Ninjago77/keyscar/CH552G Developent Board/2024-10-13T19_37_25.713Z-AR4349-Cocket-Nova-Ch552-15-1536x1519.jpg

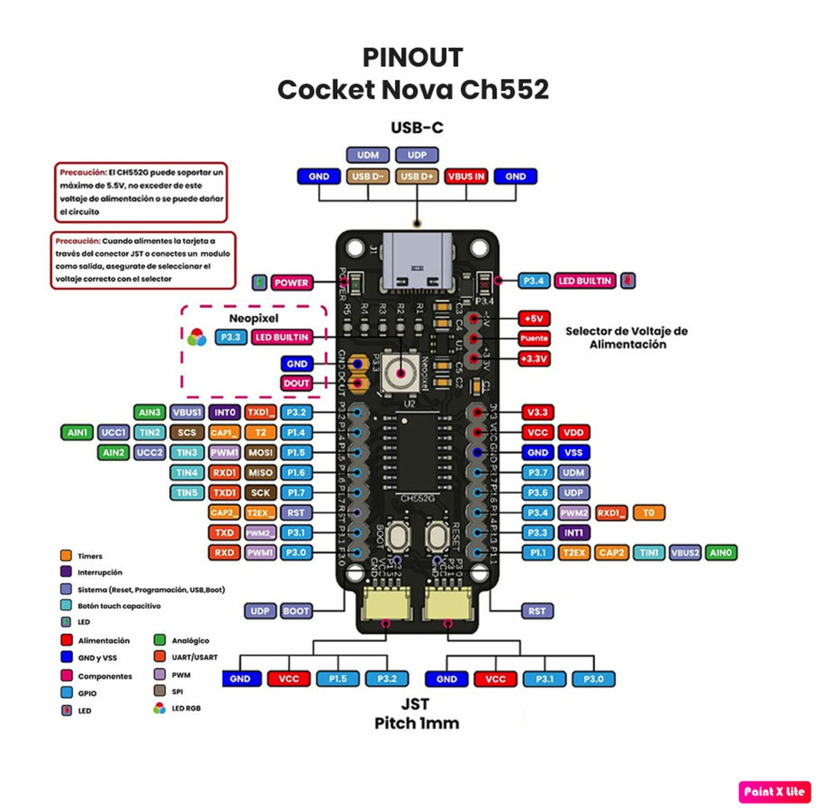
CH552G Developent Board/2024-10-13T19_37_25.713Z-AR4349-Cocket-Nova-Ch552-15-1536x1519.jpg
