Ninjago77/keyscar/images/CHIP_PLAN.png

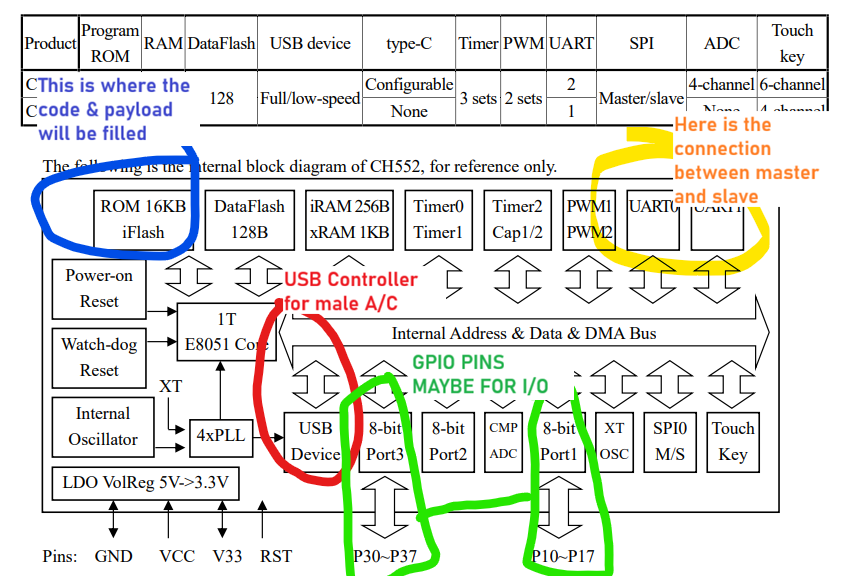
images/CHIP_PLAN.png
