Ninjago77/keyscar/images/flag-standalone-wtransparent.png

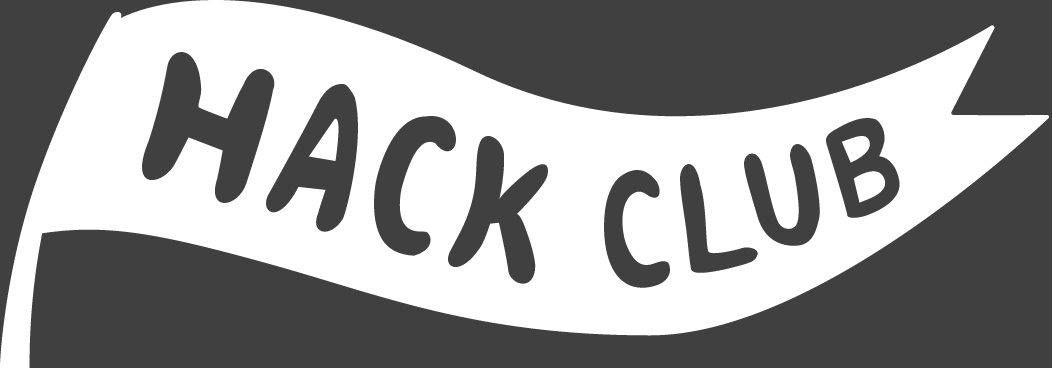
images/flag-standalone-wtransparent.png
