Ninjago77/keyscar/images/hack_monochrome.png

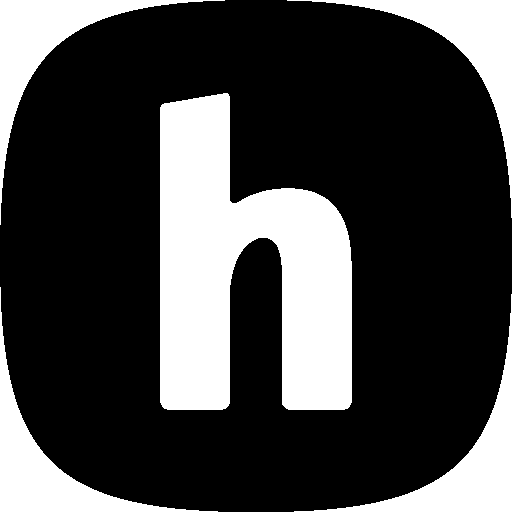
images/hack_monochrome.png
