Ninjago77/keyscar/images/imageedit_2_4769429485.png

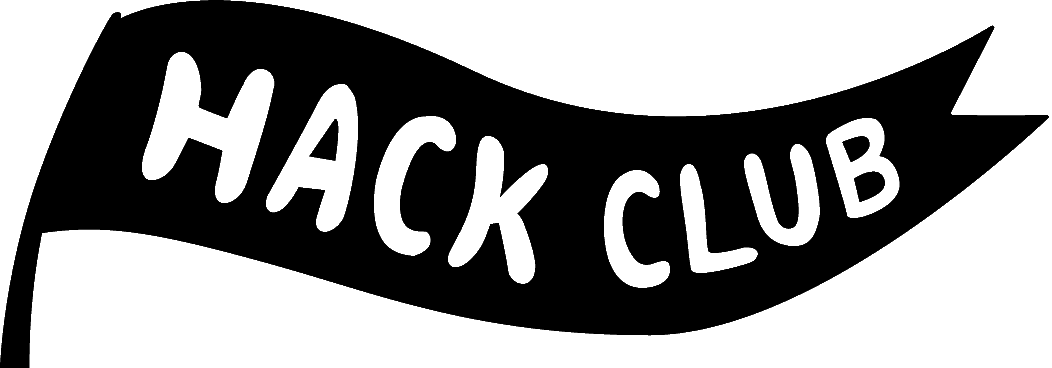
images/imageedit_2_4769429485.png
