Ninjago77/keyscar/images/imageedit_8_5918140750.png

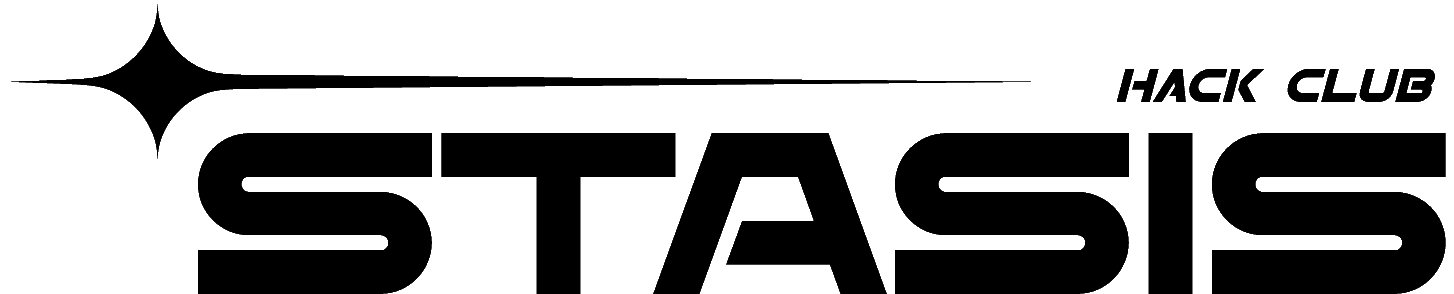
images/imageedit_8_5918140750.png
