Ninjago77/keyscar/images/PLAN.png

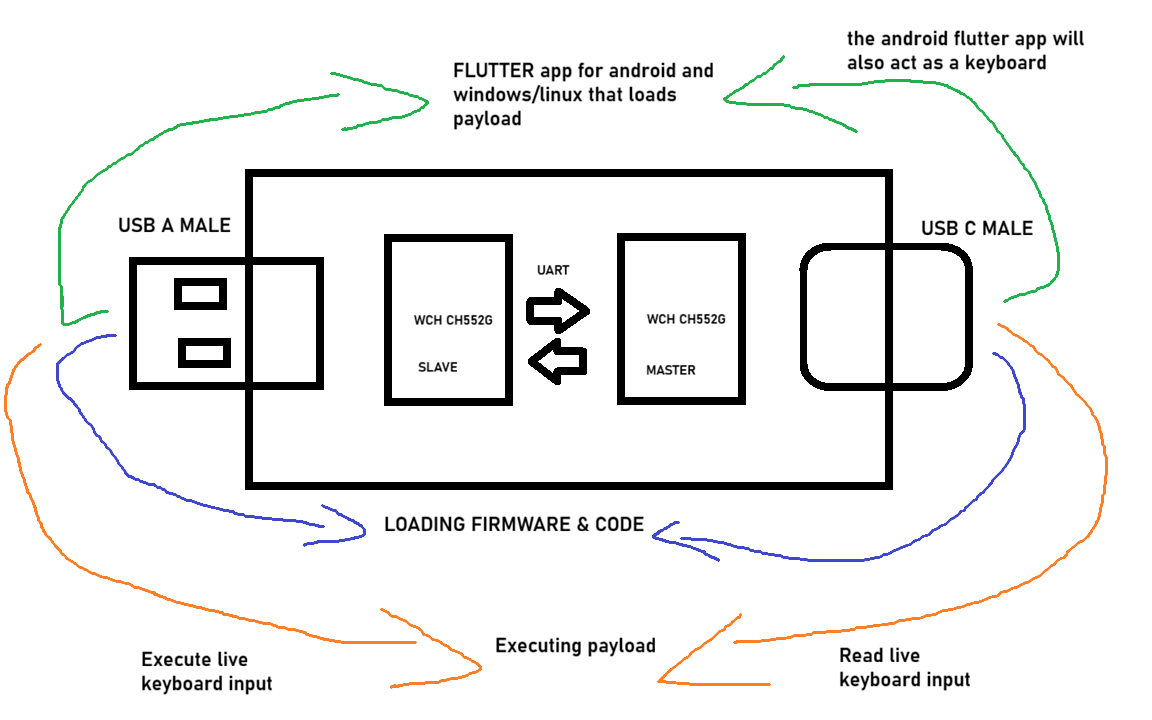
images/PLAN.png
