Ninjago77/keyscar/journal/JOURNAL_9.txt

I think, for now, I will submit the project as a tier 4 with the double-sided smd assembly.

So here are the front and back images from JCLPCB:-
 - 
 - 

And if this, along with my firmware based application, doesnt qualify for tier 4, then I'll redo the entire pcb as one
sided even though it defeats the purpose of it.

Here are the order screenshots:-
 - 
 - 

Here is the BOM CSV:-
 - 

hopefully this goes through!
