Ninjago77/keyscar/journal/JOURNAL_7.txt

So, rn, I need to fix the edge cuts for the pcb due to the drc errors I keep getting.

After some warnings about overlaps, I had to remove the ege cuts on both usb modules,
so they would stop screaming at me.

I think, I have to now go through every single footprint and remove the silkscreen
this is going to be pain.

So, I've completed that, done more touchups:-



Now its time to add the silkscreen, so I got these logos:-
 - hack_monochrome

 - imageedit_2_4769429485

 - imageedit_8_5918140750

It is done!!!:-
 - 

So now, to export and see how much it costs!

Welp, those rst & boot buttons are actually not in stock at JCLPCB,
infact, not a single one with the same footprint is in stock:-
 - 

I think I've found a way, I swapped it from 4.7mmx3.5mm to 3.5mmx4.7mm:-
 - C528967 | EVQP2202M for the rst & boot buttons

I'm going to pray that JCLPCB notices and just rotates to the correct ish footprint.

Okay, the USB C Male also had the same problem, so I found a new one:-
 - C2763098 | 918-118A2021Y40005 for the usb c male

So I think, I will have to modify the schematic and the pcb again for both of these.

The Price also looks insane, what is going on? 
The parts on their own are pretty cheap, but Setup is 50 $$???

I have to swap components and work out the price issue next journal entry.
