Ninjago77/keyscar/journal/JOURNAL_4.txt

Now to move on to actually arranging and wiring the pcb along with fetching footprints.

So before that, I ran the ERC (Electrical Rules Checker),
& I have a lot of pins unassigned, so I'm just tagging them with a passive label.

Turns out I also need to add a 5.1k resistor to GND in the usb c CC pin,
so that it can recieve power at all.
I also need to connect the shield pins on both usb a and c to GND,

so that's what i did:-
 - 
 - 

So... I think all component annotations in kicad need to end with a number,
so I think I'll have to be renaming stuff for a while.
I also had to add a bunch of PWR FLAGS everywhere to tell that it is a power source.

Now I don't have any major errors, so time to move on!

The following are the footprints I'm using:
 - Capacitor SMD:C 0402 1005 Metric
 - SS12's SMA (I had to swap it out from a tht one, so this is actually smt)
 - Neopixel SMD:LED WS2812B PLCC4 5.0x5.Omm P3.2mm
 - USB A Plug: USB_A_Molex_48037-2200_Horizontal
 - resistors: R_0402_1005Metric

I seem to have run into a problem regarding the buttons,
I want the bootsel and reset buttons to be incredibly small,
and the exec buttons to be medium, but finding the footprints for these 
small buttons (3mmx3mm) is pretty hard. Most always give me 6mm footprints.

So, I think, I have to base my footprints off of the actual parts in stock
with JCLPCB. So, here are the 2 buttons that I've picked:-
 - EVQP2D02Q for the bootsel and reset buttons
 - K2-6639SP-C4SC-04 for the EXEC buttons
 - K3-1292S-P2 for the spdt switches
 - GT36549 for the photoresistor

I think at this point, it might be better to add all the components from JCLPCB'S footprint and schematics.
So, rn this is what It looks like before I redo almost all the symbols:-
 - 

Infact, I might just redo all the footprints with the correct ones from JCLPCB,
so... I have to get the models for footprints that I mentioned above,
which means, I'll not be using a single kicad alone footprint.

So, onto more part hunting, based on availability & price (JCLPCB Part number):-
 - C112454 for USB A MALE
 - C2988371 | GT-USB-8016A for USB C MALE // not using this check down.
 - C79160 | EVQP2D02Q for the bootsel and reset buttons
 - C83206 | K2-6639SP-C4SC-04 for the EXEC buttons
 - C145853 | K3-1292S-P2 for the spdt switches
 - C2904883 | GT36549 for the photoresistor
 - C1525 | CL05B104KO5NNNC for the .1uf/ 100nf capacitors
 - C2479 | SS12 for the schottky diodes
 - C2843785 | XL-5050RGBC-2812B for the neopixels
 - C111292 | CH552G for WCH CH552G chip
 - C25531 | 0402WGJ0103TCE for the 10k ohm resistors
 - C25905 | 0402WGF5101TCE for the 5.1k ohm resistors
 - C208984 | RMS04JT330 for the 330 ohm resistors

Now onto the downloading and conversion from easyeda to kicad
for everysingle one of those footprints.

Maybe... I don't have too....
I found this plugin https://github.com/CDFER/JLCPCB-Kicad-Library
 - 

I also think I might have to install this one: https://github.com/Bouni/kicad-jlcpcb-tools

Those get me all the footprints, but I think I also need the symbols, so I must use this:-
https://pypi.org/project/JLC2KiCadLib/
and it works beautifully!

While converting my old symbols into the new ones,
I seem to have into a problem, GT-USB-8016A is a usb c female part
& I can't seem to find a usb C male part anywhere.
So as of right now, I'm going to stick with the current symbol as it is pretty descriptive.

FINALLY, it is done:-
 - 

Now to move onto the actual pcb design, as I say that, I realize that I need to,
first upload all the footprints and link them to their 3d models that I got from the pypi script
then I need to link all the footprints with their symbols.

Which I now have done!, so here is what the pcb looks like rn:
 - 

Hope I'll be able to wire it all up next journal entry and figure out the weird usb c male issue.
