Ninjago77/keyscar/keyscar_kicad/keyscar_kicad.kicad_pcb

## KiCad design keyscar_kicad/keyscar_kicad.kicad_pcb (2026-03-21)

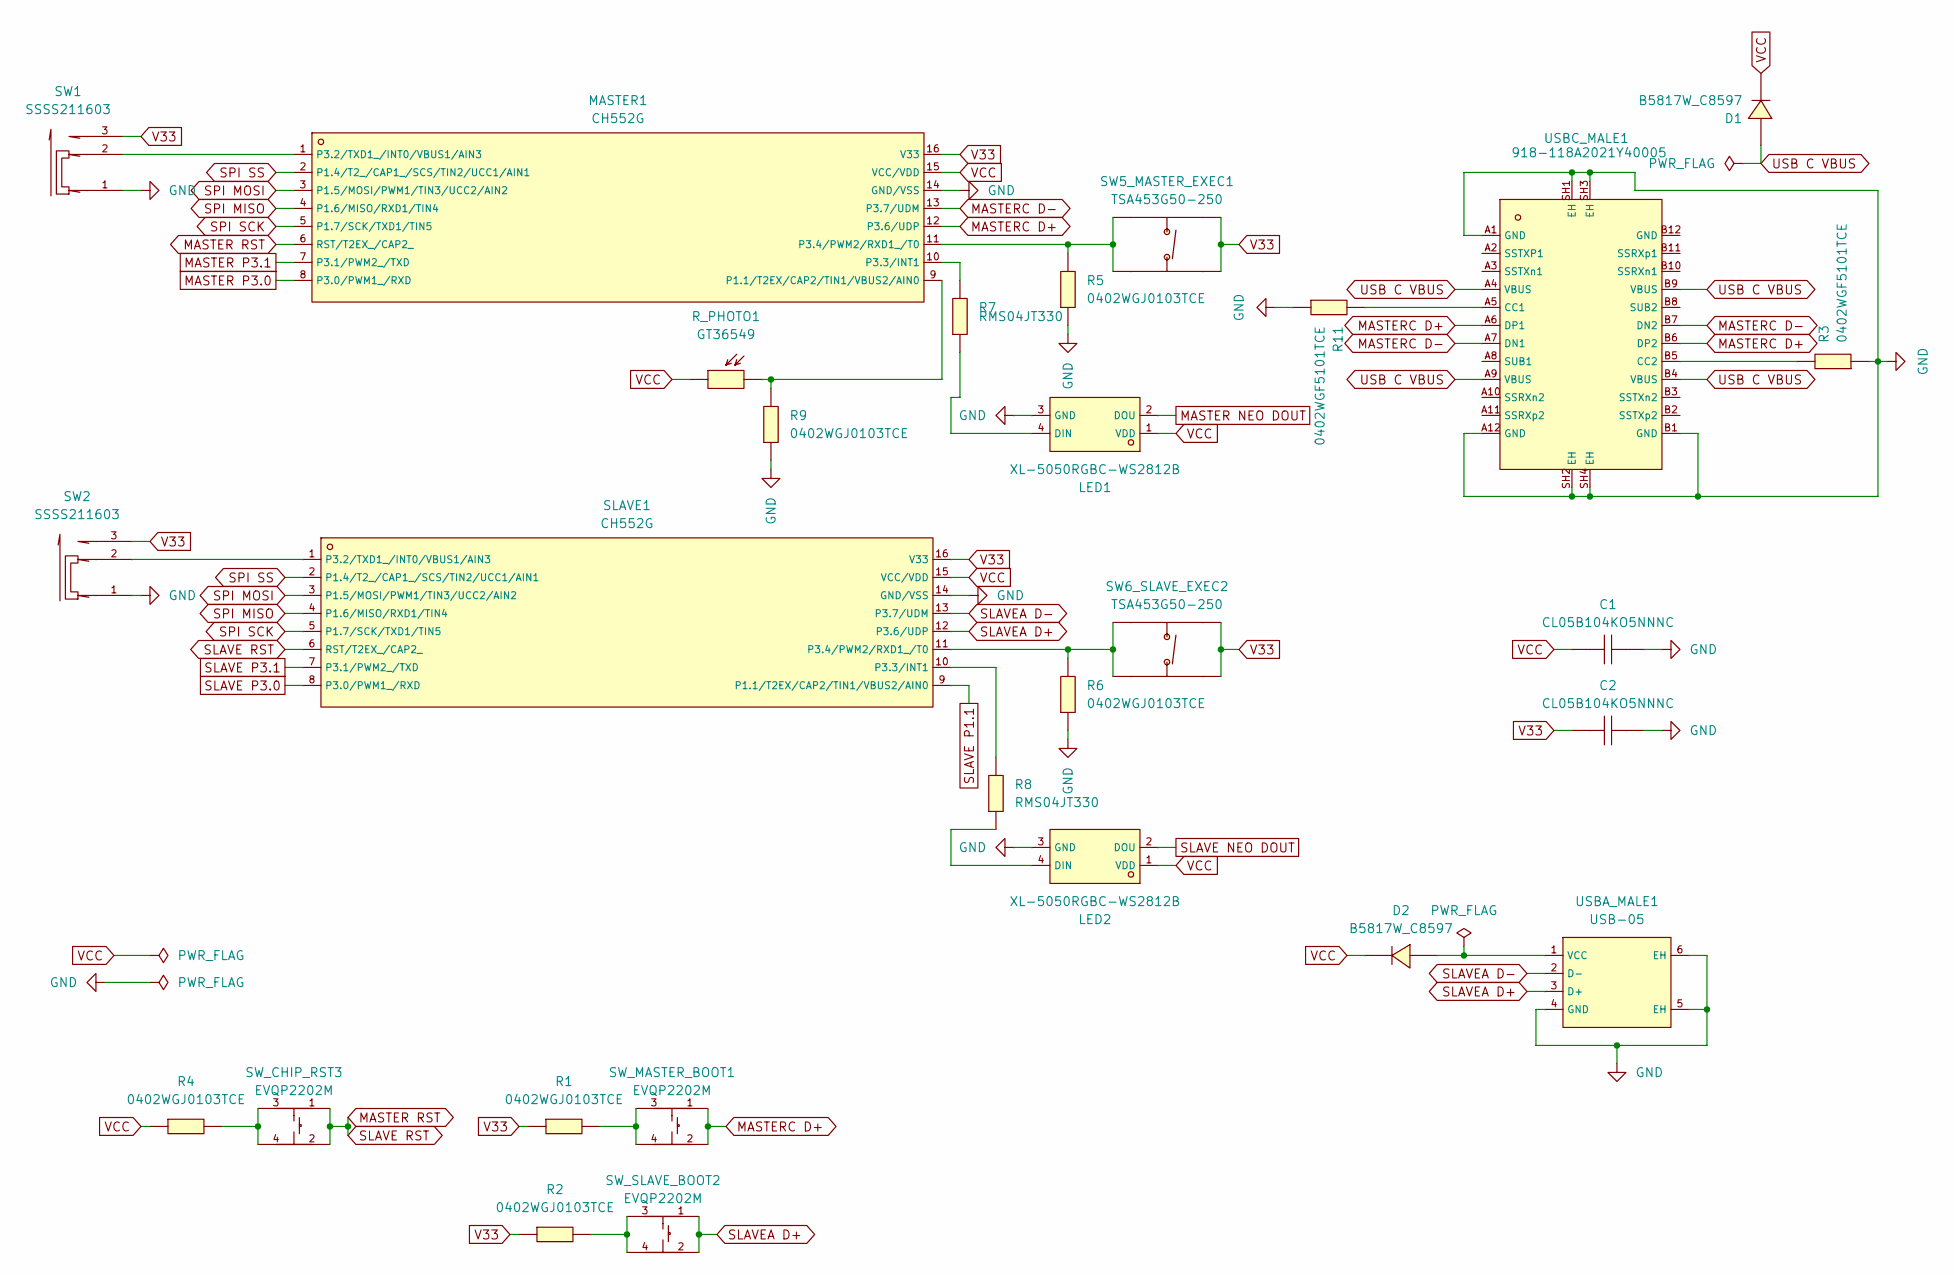
[picture p18: schematic keyscar_kicad.kicad_sch]

Parts:
C1, C2: CL05B104KO5NNNC; C0402; LCSC C1525
D1, D2: B5817W_C8597; SOD-123_L2.8-W1.8-LS3.7-RD; LCSC C8597
LED1, LED2: XL-5050RGBC-WS2812B; LED-SMD_4P-L5.0-W5.0-BL_XL-5050RGBC; LCSC C2843785
MASTER1: CH552G; SOP-16_L10.0-W3.9-P1.27-LS6.0-BL; LCSC C111292
R1, R2, R4, R5, R6, R9: 0402WGJ0103TCE; R0402; LCSC C25531
R3, R11: 0402WGF5101TCE; R0402; LCSC C25905
R7, R8: RMS04JT330; R0402; LCSC C208984
R_PHOTO1: GT36549; RES-SMD_L3.6-W2.4; LCSC C2904883
SLAVE1: CH552G; SOP-16_L10.0-W3.9-P1.27-LS6.0-BL; LCSC C111292
SW1, SW2: SSSS211603; SW-SMD_SSSS211603; LCSC C125040
SW5_MASTER_EXEC1, SW6_SLAVE_EXEC2: TSA453G50-250; KEY-SMD_4P-L4.5-W4.5-P3.00-LS7.5; LCSC C294495
SW_CHIP_RST3: EVQP2202M; SW-SMD_L4.7-W3.5-P2.00-LS5.2_EVQP2202M; LCSC C528967
SW_MASTER_BOOT1: EVQP2202M; SW-SMD_L4.7-W3.5-P2.00-LS5.2_EVQP2202M; LCSC C528967
SW_SLAVE_BOOT2: EVQP2202M; SW-SMD_L4.7-W3.5-P2.00-LS5.2_EVQP2202M; LCSC C528967
USBA_MALE1: USB-05; USB-A-TH_USB-05; LCSC C112454
USBC_MALE1: 918-118A2021Y40005; USB-C-SMD_918-118A2021Y40005; LCSC C2763098

Connections:
GND: C1.2, C2.2, LED1.3 (GND), LED2.3 (GND), MASTER1.14 (GND/VSS), R3.1, R5.1, R6.1, R9.1, R11.1, SLAVE1.14 (GND/VSS), SW1.1, SW2.1, USBA_MALE1.4 (GND), USBA_MALE1.5 (EH), USBA_MALE1.6 (EH), USBC_MALE1.A1 (GND), USBC_MALE1.A12 (GND), USBC_MALE1.B1 (GND), USBC_MALE1.SH1 (EH), USBC_MALE1.SH2 (EH), USBC_MALE1.SH3 (EH), USBC_MALE1.SH4 (EH)
MASTER NEO DOUT: LED1.2 (DOU)
MASTER P3.0: MASTER1.8 (P3.0/PWM1_/RXD)
MASTER P3.1: MASTER1.7 (P3.1/PWM2_/TXD)
MASTER RST: MASTER1.6 (RST/T2EX_/CAP2_), SLAVE1.6 (RST/T2EX_/CAP2_), SW_CHIP_RST3.1, SW_CHIP_RST3.2
MASTERC D+: MASTER1.12 (P3.6/UDP), SW_MASTER_BOOT1.1, SW_MASTER_BOOT1.2, USBC_MALE1.A6 (DP1), USBC_MALE1.B6 (DP2)
MASTERC D-: MASTER1.13 (P3.7/UDM), USBC_MALE1.A7 (DN1), USBC_MALE1.B7 (DN2)
unnamed: D2.2 (A), USBA_MALE1.1 (VCC)
unnamed: LED1.4 (DIN), R7.1
unnamed: LED2.4 (DIN), R8.1
unnamed: MASTER1.9 (P1.1/T2EX/CAP2/TIN1/VBUS2/AIN0), R9.2, R_PHOTO1.2
unnamed: MASTER1.1 (P3.2/TXD1_/INT0/VBUS1/AIN3), SW1.2
unnamed: MASTER1.10 (P3.3/INT1), R7.2
unnamed: MASTER1.11 (P3.4/PWM2/RXD1_/T0), R5.2, SW5_MASTER_EXEC1.2, SW5_MASTER_EXEC1.4
unnamed: R1.2, SW_MASTER_BOOT1.3, SW_MASTER_BOOT1.4
unnamed: R2.2, SW_SLAVE_BOOT2.3, SW_SLAVE_BOOT2.4
unnamed: R4.2, SW_CHIP_RST3.3, SW_CHIP_RST3.4
unnamed: SLAVE1.1 (P3.2/TXD1_/INT0/VBUS1/AIN3), SW2.2
unnamed: R8.2, SLAVE1.10 (P3.3/INT1)
unnamed: R6.2, SLAVE1.11 (P3.4/PWM2/RXD1_/T0), SW6_SLAVE_EXEC2.2, SW6_SLAVE_EXEC2.4
unnamed: R11.2, USBC_MALE1.A5 (CC1)
unnamed: R3.2, USBC_MALE1.B5 (CC2)
SLAVE NEO DOUT: LED2.2 (DOU)
SLAVE P1.1: SLAVE1.9 (P1.1/T2EX/CAP2/TIN1/VBUS2/AIN0)
SLAVE P3.0: SLAVE1.8 (P3.0/PWM1_/RXD)
SLAVE P3.1: SLAVE1.7 (P3.1/PWM2_/TXD)
SLAVEA D+: SLAVE1.12 (P3.6/UDP), SW_SLAVE_BOOT2.1, SW_SLAVE_BOOT2.2, USBA_MALE1.3 (D+)
SLAVEA D-: SLAVE1.13 (P3.7/UDM), USBA_MALE1.2 (D-)
SPI MISO: MASTER1.4 (P1.6/MISO/RXD1/TIN4), SLAVE1.4 (P1.6/MISO/RXD1/TIN4)
SPI MOSI: MASTER1.3 (P1.5/MOSI/PWM1/TIN3/UCC2/AIN2), SLAVE1.3 (P1.5/MOSI/PWM1/TIN3/UCC2/AIN2)
SPI SCK: MASTER1.5 (P1.7/SCK/TXD1/TIN5), SLAVE1.5 (P1.7/SCK/TXD1/TIN5)
SPI SS: MASTER1.2 (P1.4/T2_/CAP1_/SCS/TIN2/UCC1/AIN1), SLAVE1.2 (P1.4/T2_/CAP1_/SCS/TIN2/UCC1/AIN1)
USB C VBUS: D1.2 (A), USBC_MALE1.A4 (VBUS), USBC_MALE1.A9 (VBUS), USBC_MALE1.B4 (VBUS), USBC_MALE1.B9 (VBUS)
V33: C2.1, MASTER1.16 (V33), R1.1, R2.1, SLAVE1.16 (V33), SW1.3, SW2.3, SW5_MASTER_EXEC1.1, SW5_MASTER_EXEC1.3, SW6_SLAVE_EXEC2.1, SW6_SLAVE_EXEC2.3
VCC: C1.1, D1.1 (C), D2.1 (C), LED1.1 (VDD), LED2.1 (VDD), MASTER1.15 (VCC/VDD), R4.1, R_PHOTO1.1, SLAVE1.15 (VCC/VDD)

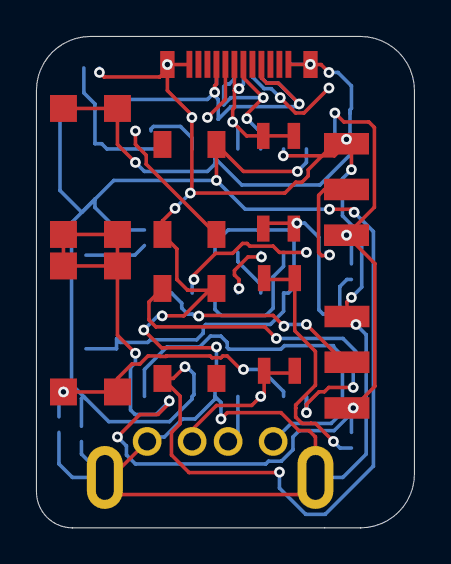
[picture p19: board keyscar_kicad.kicad_pcb from above]

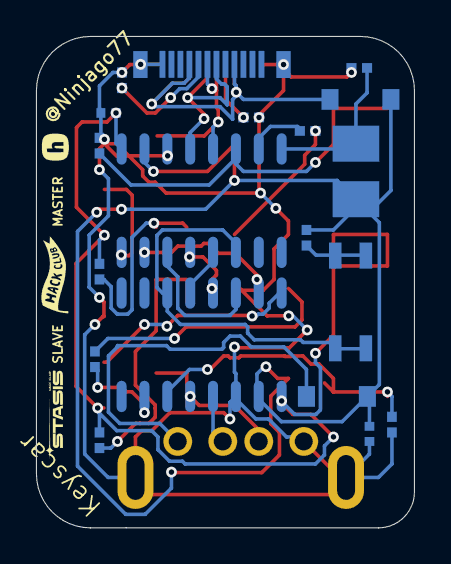
[picture p20: board keyscar_kicad.kicad_pcb from below]

Board: 2 copper layers, 21.0 x 27.3 mm, 28 parts (18 on the bottom side), 28 nets.
