Ninjago77/keyscar/(commit log)

2026-03-18 actually did some research hoarding and schematic making
    [keyscar_kicad.kicad_pcb, keyscar_kicad.kicad_sch]
2026-03-19 Fixing Schematic, Redoing it with Part-Symbols & Connecting footprints, symbols, 3d models alltogether
    [keyscar_kicad.kicad_pcb, keyscar_kicad.kicad_sch]
2026-03-20 Getting Started on Wiring the PCB & Substituting Parts
    [keyscar_kicad.kicad_pcb, keyscar_kicad.kicad_sch]
2026-03-20 Wrapping up the PCB, wiring the VCC, V33, GND
    [keyscar_kicad.kicad_pcb, keyscar_kicad.kicad_sch]
2026-03-20 medium commit
    [keyscar_kicad.kicad_pcb]
2026-03-20 safety commit
    [keyscar_kicad.kicad_pcb]
2026-03-21 Wrapped up PCB & Silkscreen, worked on BOM & Purchasing
    [keyscar_kicad-B_Cu.gbr, keyscar_kicad-B_Mask.gbr, keyscar_kicad-B_Paste.gbr, keyscar_kicad-B_Silkscreen.gbr, keyscar_kicad-Edge_Cuts.gbr, keyscar_kicad-F_Cu.gbr, keyscar_kicad-F_Mask.gbr, keyscar_kicad-F_Paste.gbr]
2026-03-21 safety commit again
    [keyscar_kicad-B_Cu.gbr, keyscar_kicad-B_Mask.gbr, keyscar_kicad-B_Paste.gbr, keyscar_kicad-B_Silkscreen.gbr, keyscar_kicad-Edge_Cuts.gbr, keyscar_kicad-F_Cu.gbr, keyscar_kicad-F_Mask.gbr, keyscar_kicad-F_Paste.gbr]
2026-03-21 :( Old peak 2 sided
    [bom.xlsx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]
2026-03-21 Working on Silkscreen & Suffering through the Pain that is PCBA ordering
2026-03-22 Worked on converting BOM to Stasis BOM
    [STASIS_BOM.csv, bom.xls]
